dakloifarwa/Astroschelle-SY135/README.md

# Astroschelle
Astroschelle is an Open-Source-Hardware project for astronomy applications. It is a dove tail and tripod adapter for the Samyang/Walimex/Rokinon 135mm/T2.2 lens.
The source files can be opened and modified with the latest OpenSCAD Version (http://www.openscad.org/).
