dakloifarwa/Astroschelle-SY135/CAM Files/V11/Teilring hinten V1.1.stl

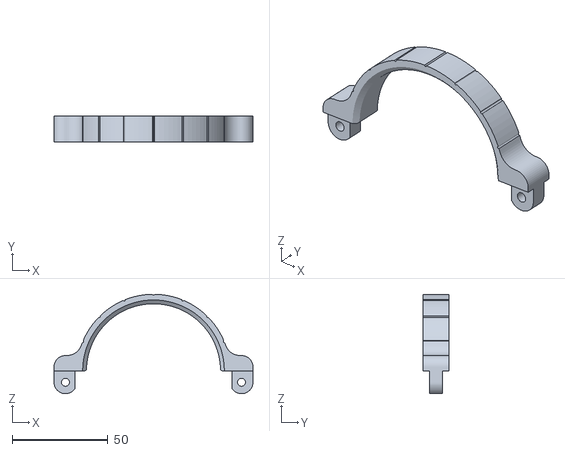
[picture p1: CAD file, 2016-05-15]
CAM Files/V11/Teilring hinten V1.1.stl
104.1 x 13.5 x 52.0
