dakloifarwa/Astroschelle-SY135/CAM Files/V11/Astroschelle V1.1.stl

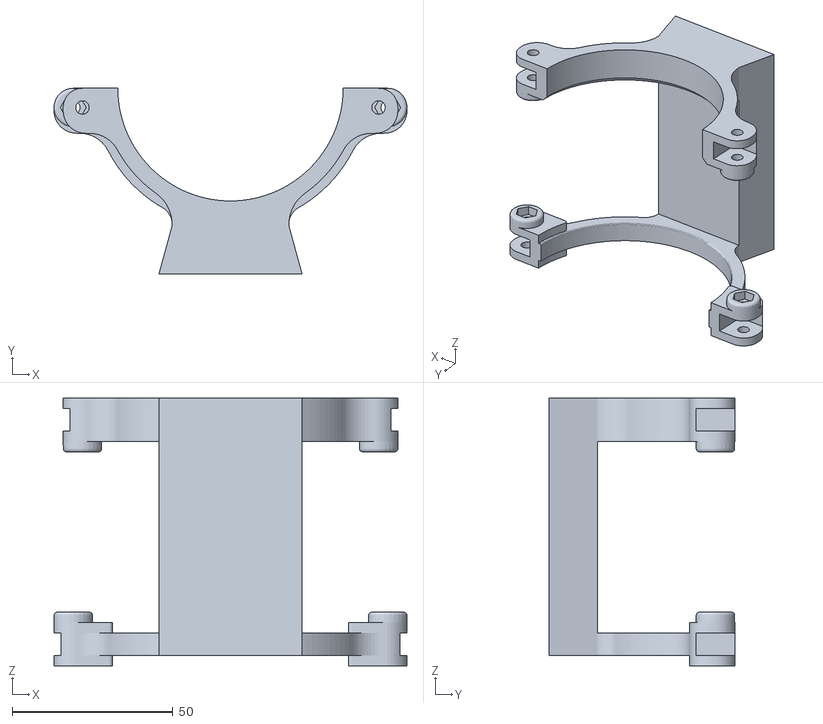
[picture p2: CAD file, 2016-05-15]
CAM Files/V11/Astroschelle V1.1.stl
109.8 x 57.7 x 83.2
