dakloifarwa/Astroschelle-SY135/CAM Files/V11/Teilring vorne V1.1.stl

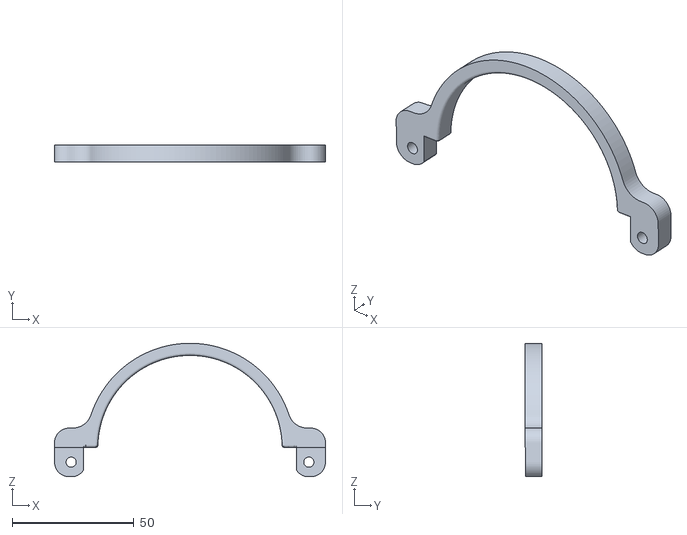
[picture p3: CAD file, 2016-05-15]
CAM Files/V11/Teilring vorne V1.1.stl
111.5 x 7.00 x 54.9
