dakloifarwa/Astroschelle-SY135/CAD Files/V10/Teilring vorne V1.0.FCStd

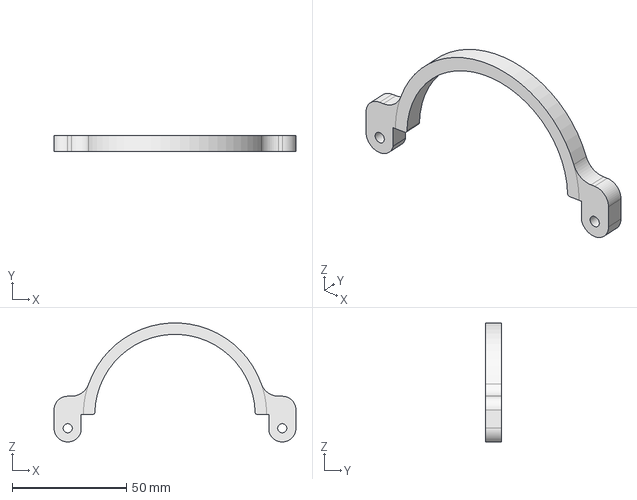
[picture p4: CAD file, 2016-05-14, an earlier design]
CAD Files/V10/Teilring vorne V1.0.FCStd
105.8 x 7.00 x 52.0 mm
