dakloifarwa/Astroschelle-SY135/CAD Files/V10/Teilring hinten V1.0.FCStd

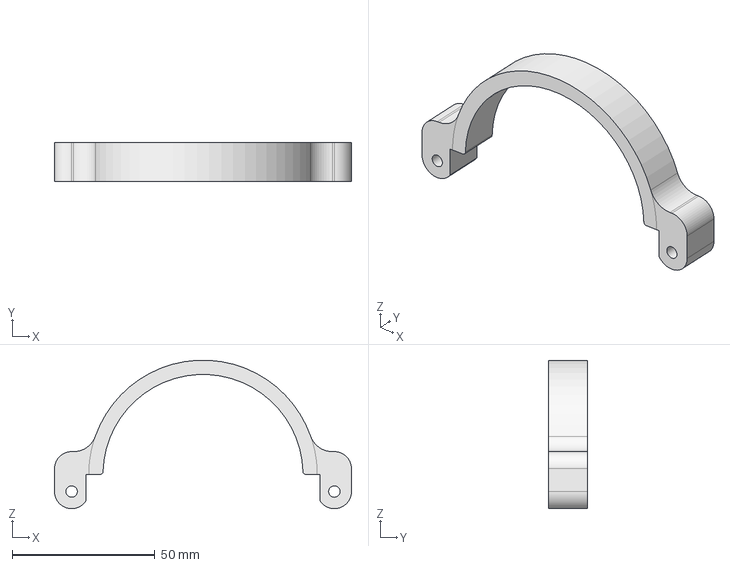
[picture p5: CAD file, 2016-05-14, an earlier design]
CAD Files/V10/Teilring hinten V1.0.FCStd
104.1 x 13.5 x 52.0 mm
