dakloifarwa/Astroschelle-SY135/(list of files, cad)

Other CAD files:
CAD Files/V11/Astroschelle V1.1.FCStd
CAM Files/V10/Astroschelle V1.0.stl
CAD Files/V10/Astroschelle V1.0.FCStd
CAD Files/V11/Teilring vorne V1.1.FCStd
CAM Files/V10/Teilring vorne V1.0.stl
CAD Files/V11/Teilring hinten V1.1.FCStd
CAM Files/V10/Teilring hinten V1.0.stl
CAD Files/V21/Astroschelle V21.scad
CAD Files/V23/Astroschelle V23.scad
