dakloifarwa/Astroschelle-SY135/(threads)

Thread 5 (2016-05-15):

Stativanschluss

dakloifarwa, 2016-05-15:
Fotogewinde 3/8“ mittig in den Schwalbenschwanz einsetzen, um darin einen Adapter 3/8" auf 1/4" Gewinde einzuschrauben. Dazu den Schwalbenschwanz vorher mit Material auffuellen / massiv gestalten

DKF-Engineering, 2017-07-31:
Die einfache Bohrung zum selber Gewindeschneiden ist zu fehleranfällig. Die Schrauben der Stativköpfe ragen meist nur sehr kurz (4-5mm) aus dem Stativkopf. Schneidet man eine zu große Fase oder beginnt das Gewinde zu weit innen, besteht die Gefahr, dass die Schraubverbindung nicht hält. Daher besser eine fertige Schraube sehr nah am Boden einsetzen. Oder alternativ ein Einsetzteil aus Fernost mit Befestigungsschrauben suchen.

dakloifarwa, 2018-01-30:
Erledigt! In V2.2 ist jetzt eine Aufnahme für eine 3/8" UNC-Mutter. In diese kann man einen extralangen Gewindeadapter 1/4" auf 3/8" einsetzen (Länge 8.5mm), z. B.:
[https://www.ebay.de/itm/1-4-3-8-Adapter-lange-Ausfuehrung-2-Stueck-1-4-Kupplung-Stativgewinde-/222449374357](https://www.ebay.de/itm/1-4-3-8-Adapter-lange-Ausfuehrung-2-Stueck-1-4-Kupplung-Stativgewinde-/222449374357)

dakloifarwa, 2020-01-08:
Update: eBay-Link veraltet, Adapter verfügbar unter: [https://www.fotoschraubenshop.de/produkte/adapter-zoll-zoll/adapter-1-4-3-8/] ->Adapter 1/4"-3/8" lang mit Bund
Hier sind auch passende Muttern zu finden!

Closed 2018-01-30.

Thread 13 (2016-05-16):

Rändelschrauben

dakloifarwa, 2016-05-16:
Rändelschrauben mit Absatz einsetzen! Ohne Absatz ist es schwierig, die Schraube zu greifen.
Größe: M4x20

DKF-Engineering, 2017-04-01:
Neue Kunststoff-Rändelschrauben gefunden von Schneider Consulting:
Kunststoff Rändelschrauben mit Schlitz M4 20mm natur 10 Stück:
http://www.ebay.de/itm/361488299679
Kunststoff Mutter Sechskantmutter M4 DIN EN 34814 1587 10 Stück:
http://www.ebay.de/itm/390543942593

DKF-Engineering, 2017-04-01:
1mm Absatz als Auflage für neue Nylon-Rändelschrauben

dakloifarwa, 2017-10-06:
erledigt, s. V2.0

Closed 2017-10-06.

Thread 14 (2016-05-16):

Fokusring - vorderen Ring

DKF-Engineering, 2016-05-16:
Fokusring des Objektivs überlappt den vorderen Ring und kann dadurch blockiert werden. Daher den vorderen Ring mit 1mm Fase versehen

DKF-Engineering, 2016-05-16:
erledigt, s. V1.1

Closed 2016-05-16.

Thread 16 (2016-05-16):

Datenproblem Fertigungsdienstleister

dakloifarwa, 2016-05-16:
Die hintere Auflage ist nicht kreisrund ausgedruckt, es ist eine flache Stelle erkennbar. Ist anscheinend ein Produktionsproblem bei Meltwerk!?
STL-Datei ist an dieser Stelle in Ordnung!
Bei erneutem Auftreten Reklamation!

DKF-Engineering, 2017-04-01:
bei V1.1 immer noch vorhanden

dakloifarwa, 2017-10-06:
erledigt bei V2.0

Closed 2017-10-06.

Thread 6 (2016-05-16):

Winkelmarkierungen

dakloifarwa, 2016-05-16:
Winkelmarkierungen, um Rotationswinkel der Kamera leichter einstellen zu können

DKF-Engineering, 2016-05-16:
erledigt, s. V1.1

DKF-Engineering, 2017-03-17:
Anwendbarkeit verbessern, indem die Markierungen auch auf der Seite fortgeführt werden.

dakloifarwa, 2017-10-06:
erledigt, s. V2.0

Closed 2017-10-06.

Thread 8 (2016-05-16):

Schelle mit Velours auskleiden

dakloifarwa, 2016-05-16:
Schelle mit Velours auskleiden, damit sich das Objektiv leichter drehen lässt. Dazu wird es wohl nötig sein, den Innendurchmesser der Schellenringe leicht zu erhöhen (ca. 0,5mm).

dakloifarwa, 2017-10-06:
obsolet bei V2.0, da Klemmspannung variabel

Closed 2017-10-06.

Thread 9 (2016-05-16):

Fertigungstoleranzen - Verschluss vorderer Ring

DKF-Engineering, 2016-05-16:
Verschluss des vorderen Rings passt nicht in die Aufnahme, aufgrund Produktionstoleranzen => Verschluss am Ring auf Spielpassung erweitern

DKF-Engineering, 2016-05-16:
erledigt, s. V1.1

Closed 2016-05-16.

Thread 19 (2017-03-17):

Objektiv besser fixieren

dakloifarwa, 2017-03-17:
Das Objektiv kann unter Umständen in den Tubusringen 1-2mm zurückrutschen. Kann bei der Standardvariante ohne Zahnkranz problematisch werden.

dakloifarwa, 2017-10-06:
Zumindest ein Hinweis ins Manual usw.

dakloifarwa, 2018-01-30:
Hinweis auf Produktseite eingefügt, siehe unter "General Informations":
https://www.dakloifarwa.com/products/astroschelle/

Closed 2018-01-30.

Thread 24 (2017-06-09):

Parametersatz für zweite Cine-Reihe von Samyang ergänzen

dakloifarwa, 2017-06-09:
Von Samyang gibt es eine zweite Objektivreihe aus der Cine-Kollektion, die andere Durchmesser/Abstände der Zahnkränze hat. Dazu die nötigen Parameter per Variable umschalten

dakloifarwa, 2018-01-30:
Erledigt! V2.2 beinhaltet die Umschaltung auf neue Parameter für das Samyang 35mm F/1.2 bzw. T/1.3 (Cine-Variante)

Closed 2018-01-30.
