dakloifarwa/Astroschelle-SY135/(commit log)

2016-05-14 NEW: Transferred project files from SVN to github
    [Astroschelle V1.0.FCStd, Astroschelle V1.0.stl, Astroschelle V1.1.FCStd, Revision.ods, Teilring hinten V1.0.FCStd, Teilring hinten V1.0.stl, Teilring hinten V1.1.FCStd, Teilring vorne V1.0.FCStd]
2016-05-15 NEW: V1.1
    [Astroschelle V1.1.FCStd, Revision.ods, Teilring hinten V1.1.FCStd, Teilring vorne V1.1.FCStd]
2016-05-15 CHG: Renamed host folders
    [Astroschelle V1.0.FCStd, Astroschelle V1.0.stl, Astroschelle V1.1.FCStd, Teilring hinten V1.0.FCStd, Teilring hinten V1.0.stl, Teilring hinten V1.1.FCStd, Teilring vorne V1.0.FCStd, Teilring vorne V1.0.stl]
2016-05-15 NEW: V1.1 output files
    [Astroschelle V1.1.stl, Teilring hinten V1.1.stl, Teilring vorne V1.1.stl]
2017-06-09 CHG: totally rewritten in OpenSCAD NEW: see Github issues list BUG: see Github issues list
    [Astroschelle V20.scad, Revision.ods]
2017-06-09 CHG: Auflösung für Produktion erhöht
    [Astroschelle V20.scad]
2017-10-06 BUG: hinteren Ring verengt CHG: Verschluesse versteift
    [Astroschelle V20.scad]
2017-10-06 BUG: Version nicht hochgezaehlt, hiermit korrigiert
    [Astroschelle V21.scad]
2017-10-06 NEW: Logo und OSHWA Certification Mark, vorne und hinten
    [Astroschelle V21.scad]
2017-10-06 BUG: manifold Fehler repariert
    [Astroschelle V21.scad]
2018-01-30 NEW: Nylon screw (for assembly purposes only)
    [Astroschelle V21.scad]
2018-01-30 CHG: transparency reverted
    [Astroschelle V21.scad]
2018-01-30 NEW: tripod adapter NEW: version switch for new lens (Samyang 35mm F/1.2)
    [Astroschelle V22.scad]
2018-01-30 CHG: updated the parameters of the thread adapter
    [Astroschelle V22.scad]
2018-02-01 CHG: reverted to default (135mm lens)
    [Astroschelle V22.scad]
2018-02-01 NEW: STL files for production purposes
2018-04-06 BUG: tighter tolerances for the tripod adapter parts
    [Astroschelle V22.scad]
2018-06-12 NEW: Version 2.3 for fixing the dovetail issue
    [Astroschelle V23.scad]
2018-06-13 BUG: fixed the dimensions of the dovetail
    [Astroschelle V23.scad]
2020-02-02 BUG: enhanced tolerances for tripod mount
    [Astroschelle V23.scad, Astroschelle V24.scad]
2020-02-02 BUG: latest commit was wrong - V23 restored (V24 with enhanced tolerances of the tripod mount and without dakloifarwa logo)
    [Astroschelle V23.scad]
